jonasblixt/bebop/README.md

# bebop
Power-over-ethernet BLE bridge. This is a work in progress. 

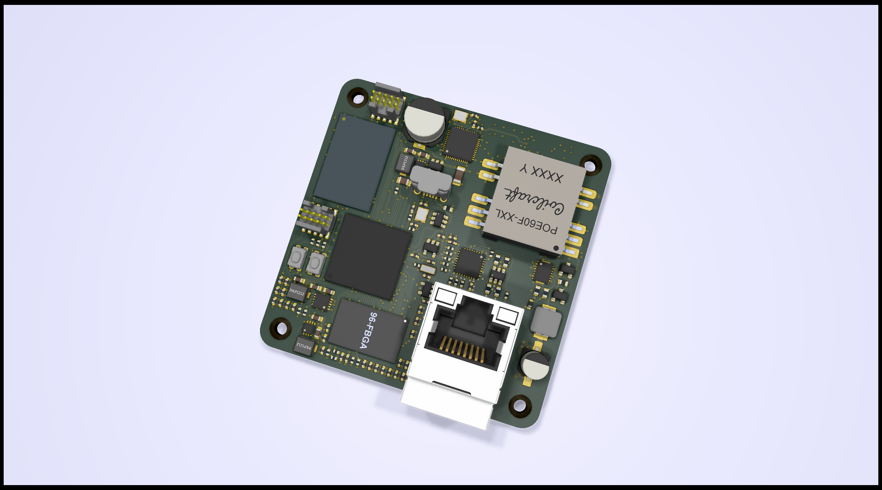
[picture p1: hw/release/R1/Bebop R1 3D front.png]
Bebop PCB
