jonasblixt/bebop/hw/release/R1/Bebop R1 3D back.png

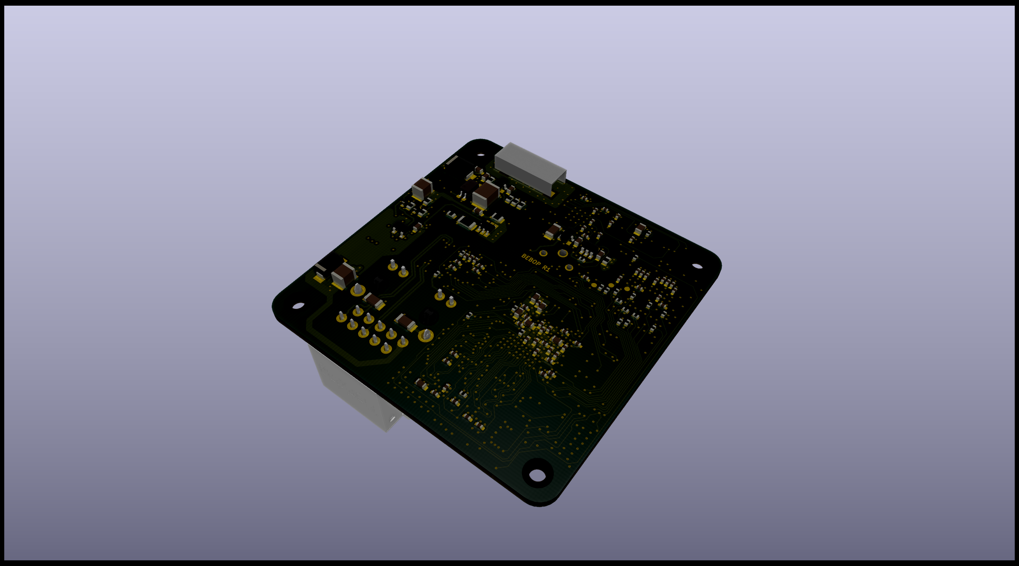
hw/release/R1/Bebop R1 3D back.png
