jonasblixt/bebop/hw/release/R1/Bebop R1 Schematics.pdf

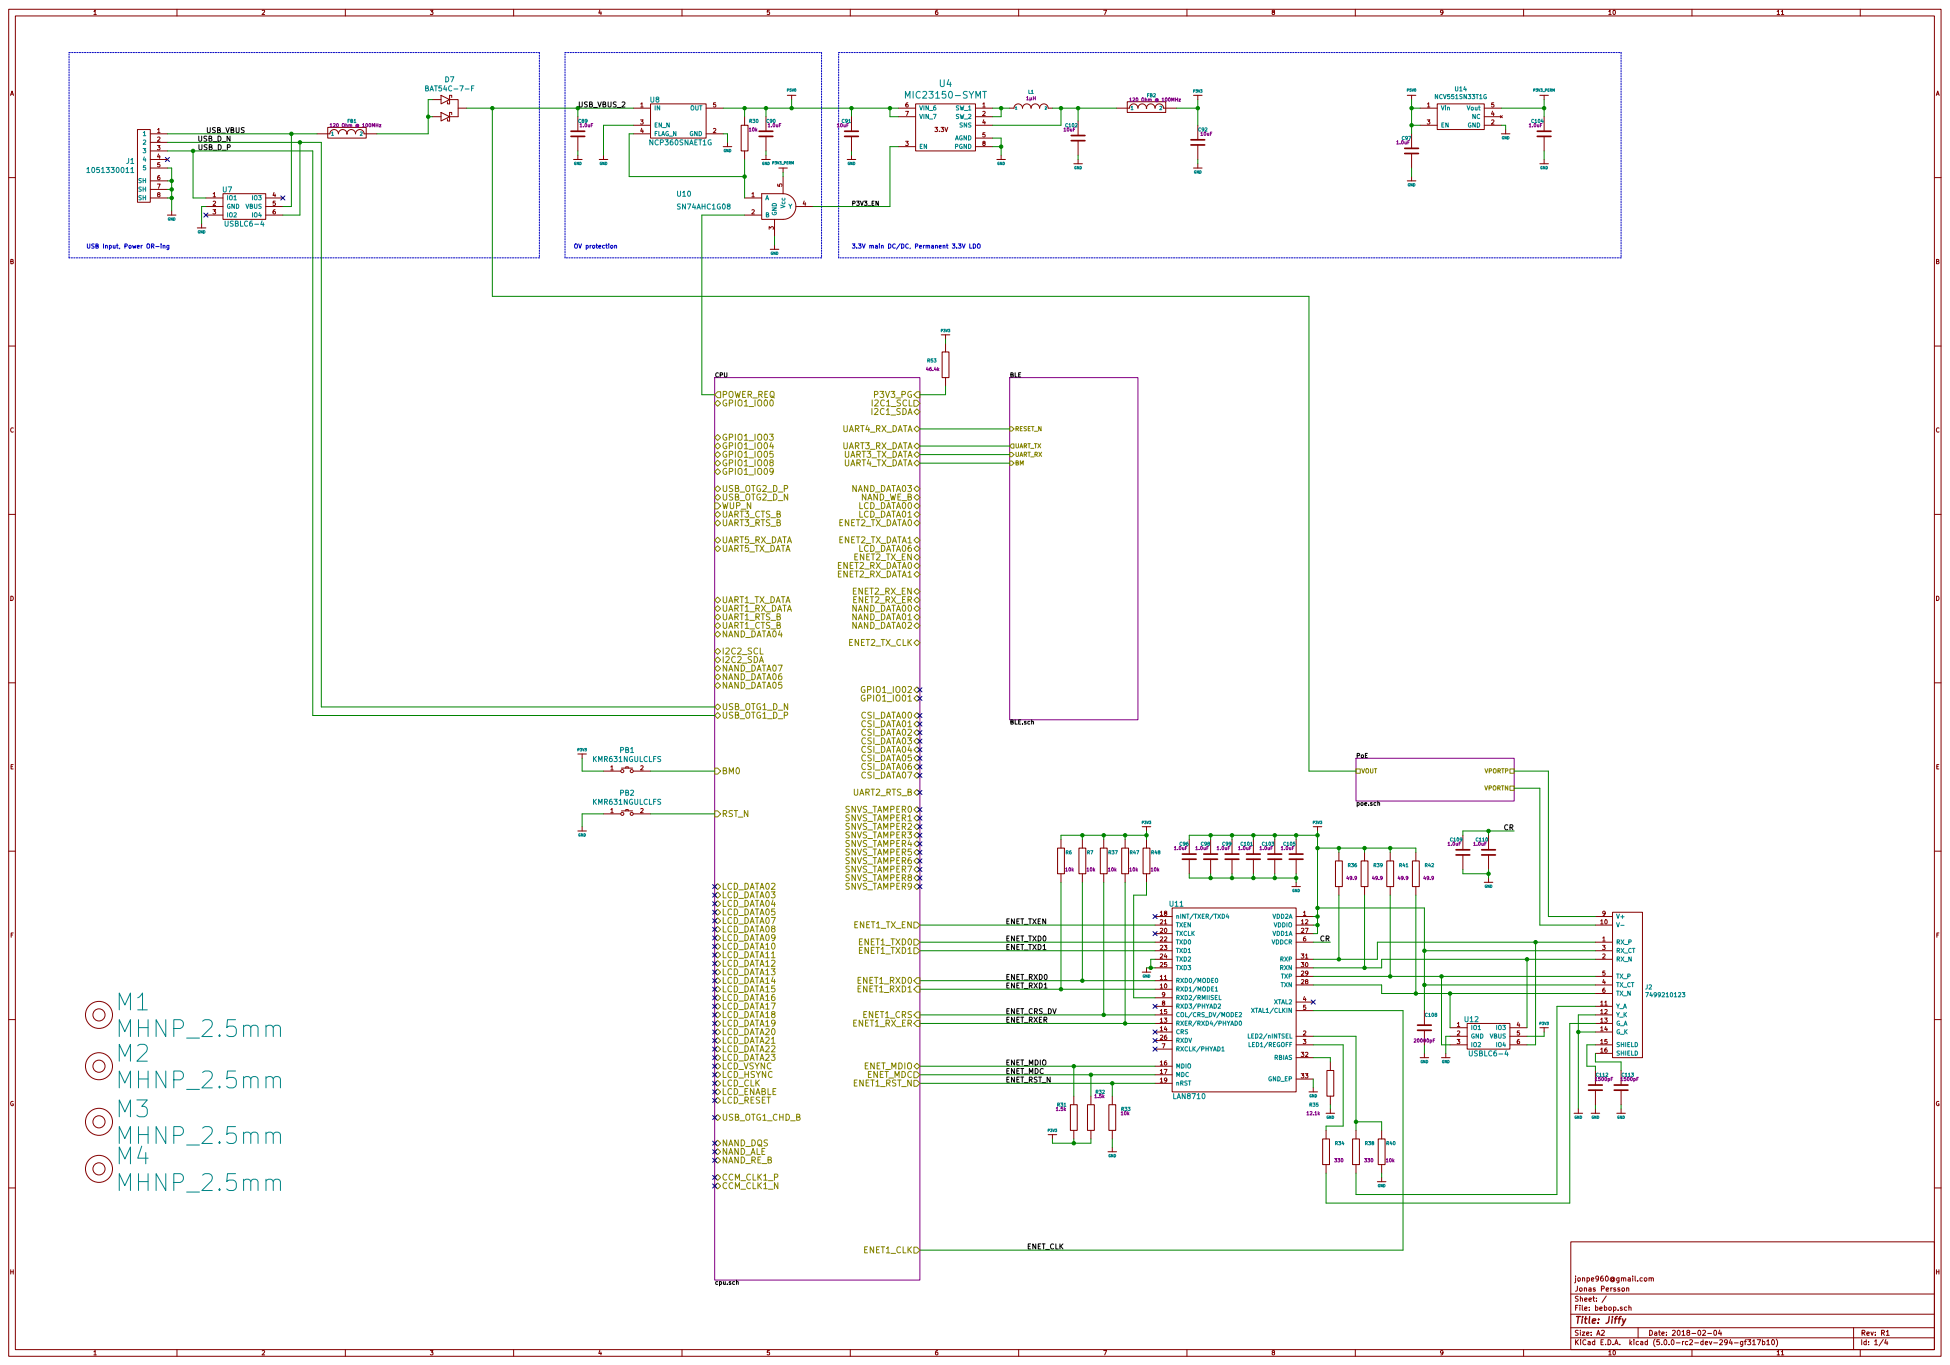
[picture p3: page 1]

ENET_MDC
ENET_RST_N | nRST 19

jonpe960@gmail.com
File: bebop.sch Sheet: / Jonas Persson

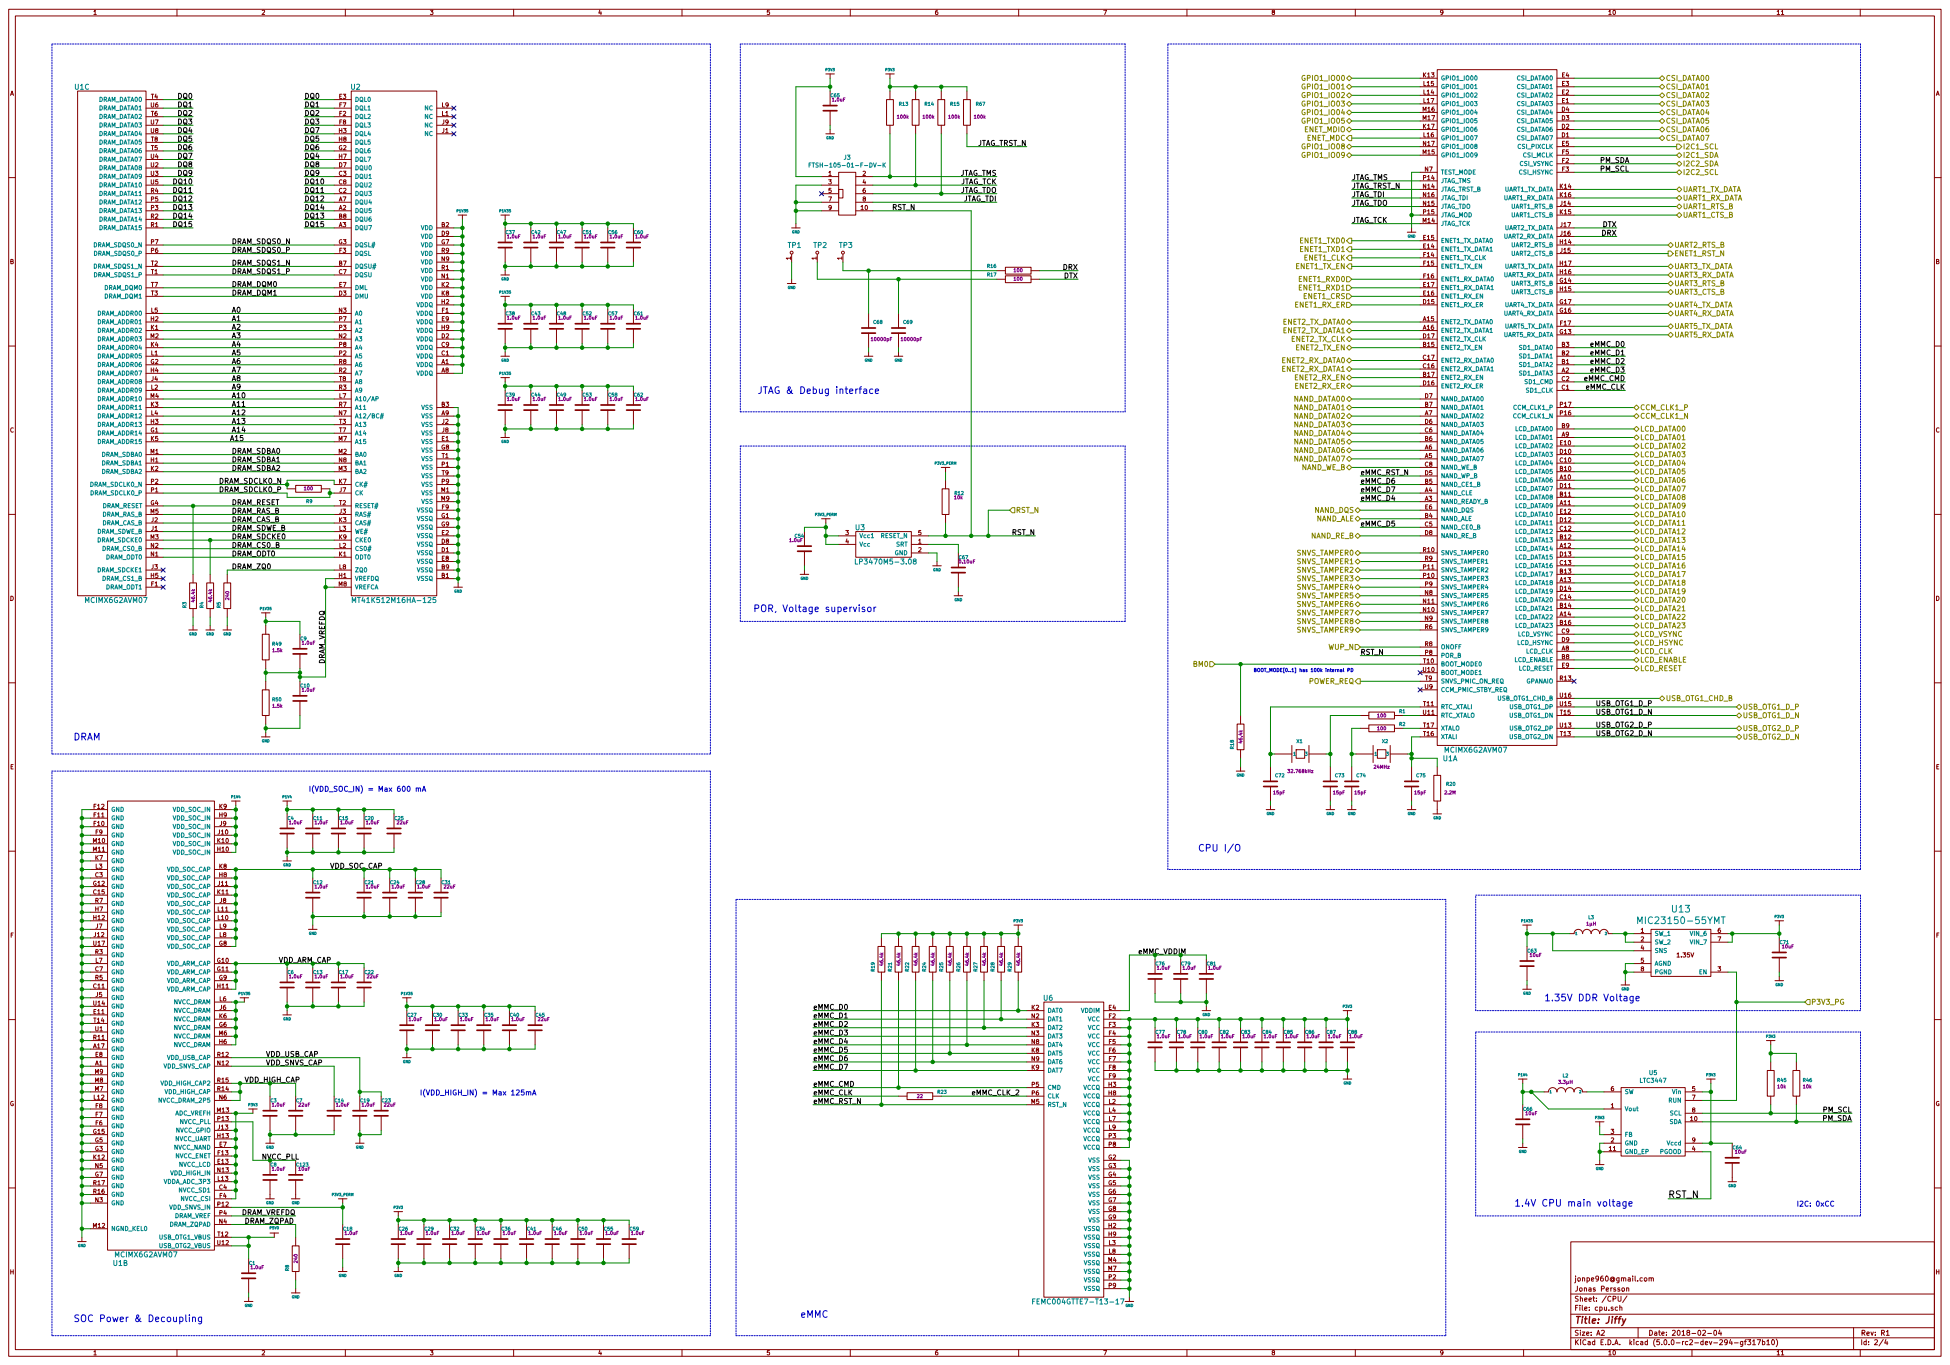
[picture p4: page 2]

GND 1.4V CPU main voltage

jonpe960@gmail.com
File: cpu.sch Sheet: /CPU/ Jonas Persson

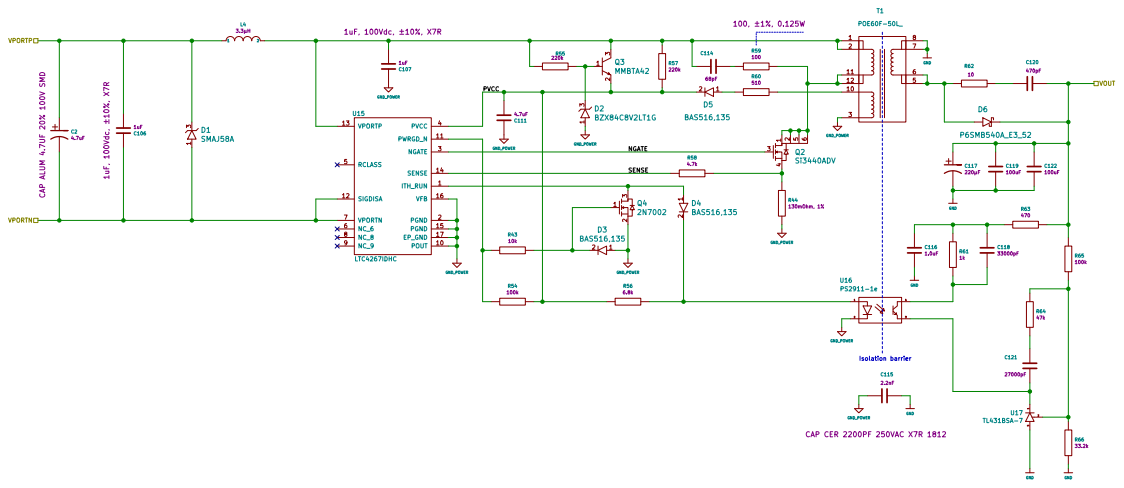
[picture p5: page 3]

File: poe.sch Sheet: /PoE/

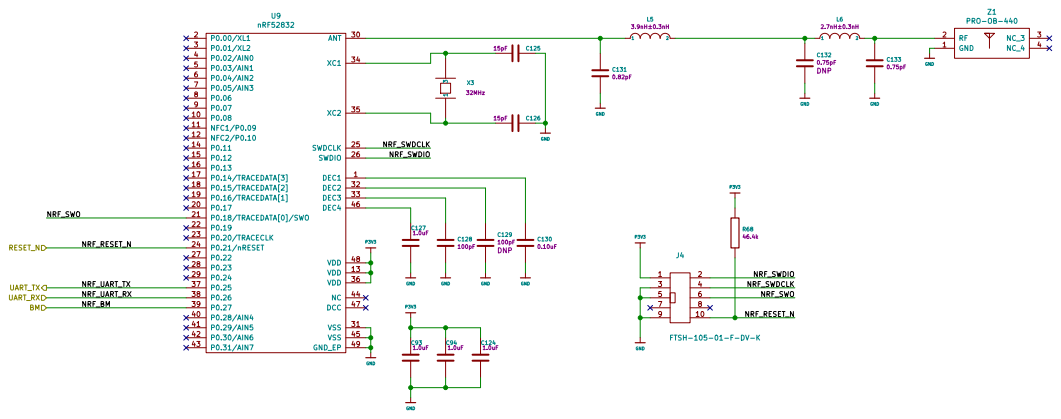
[picture p6: page 4]

Id: 4/4 Title: File: BLE.sch Sheet: /BLE/
