jonasblixt/bebop/hw/release/R1/Bebop R1 Assy.pdf

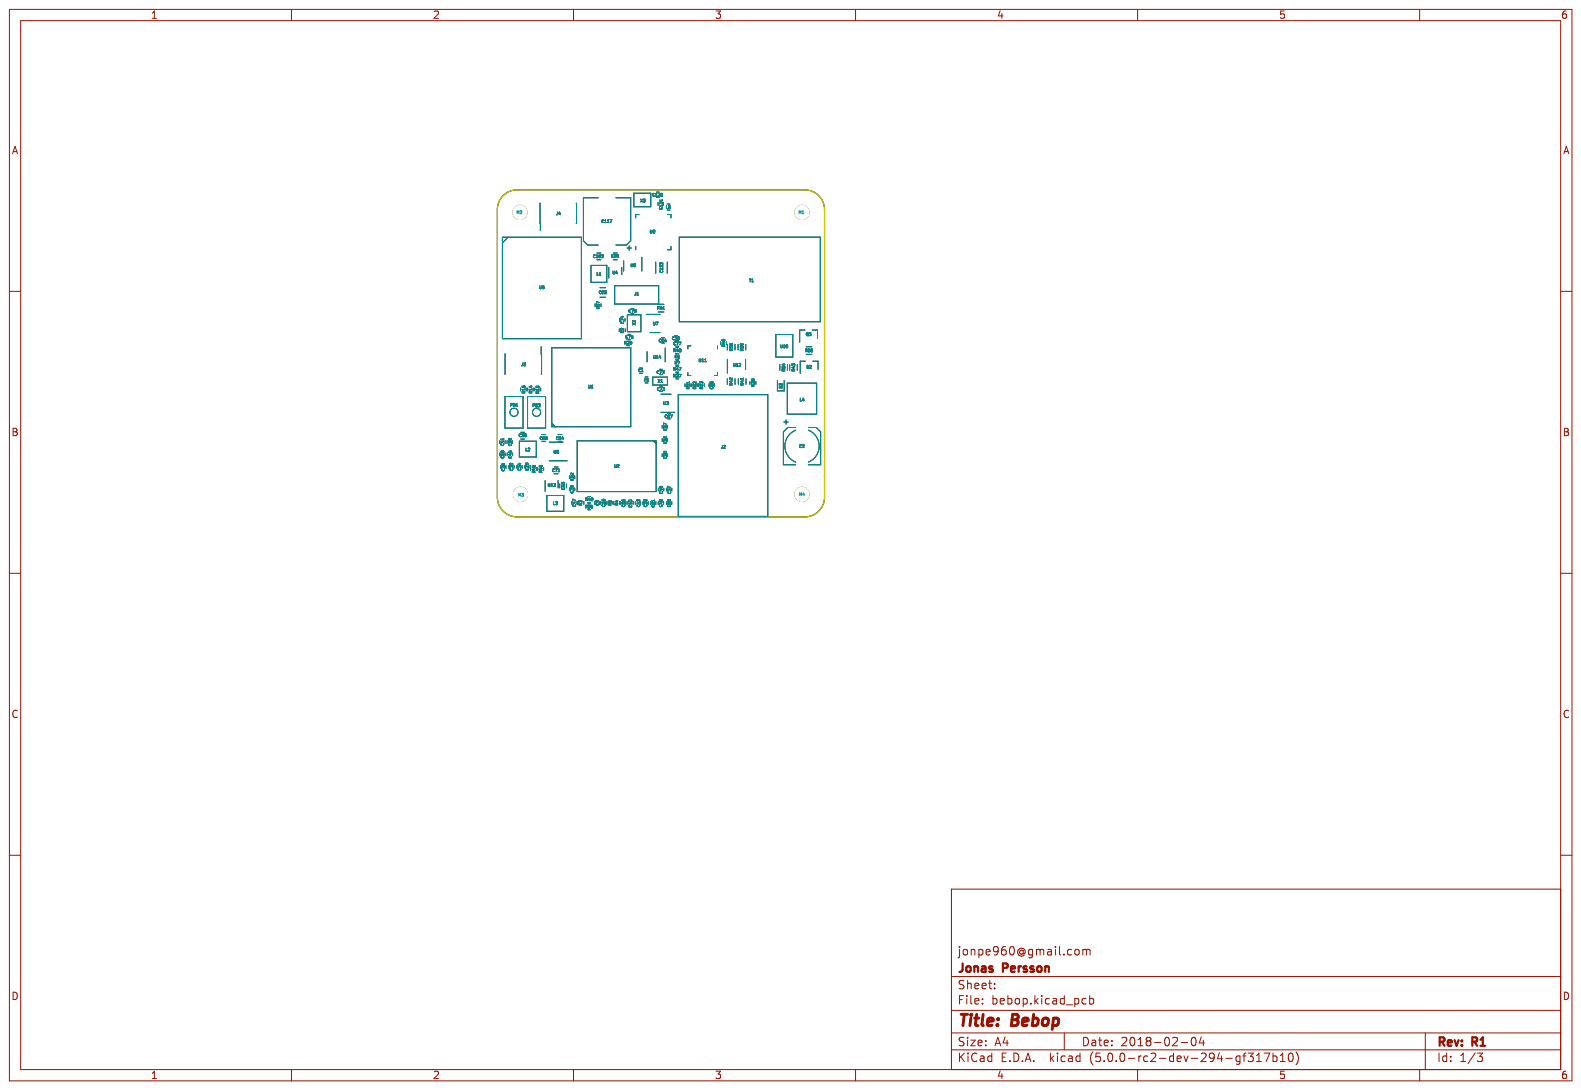
[picture p7: page 1]

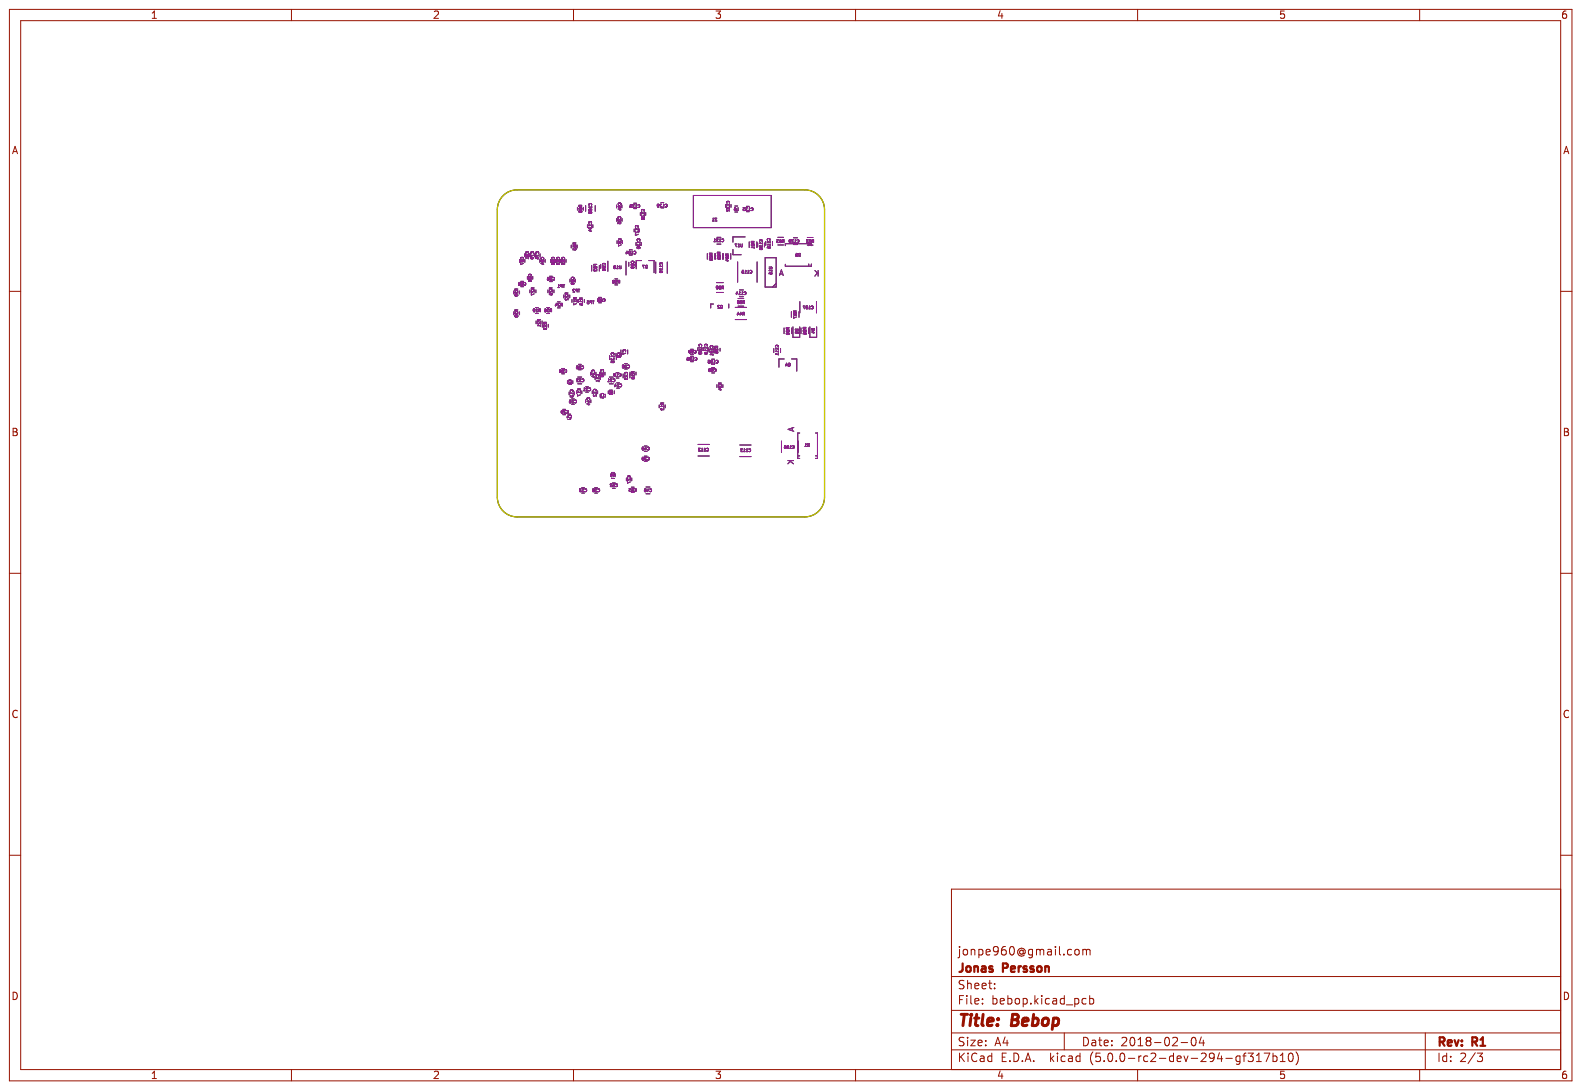
[picture p8: page 2]

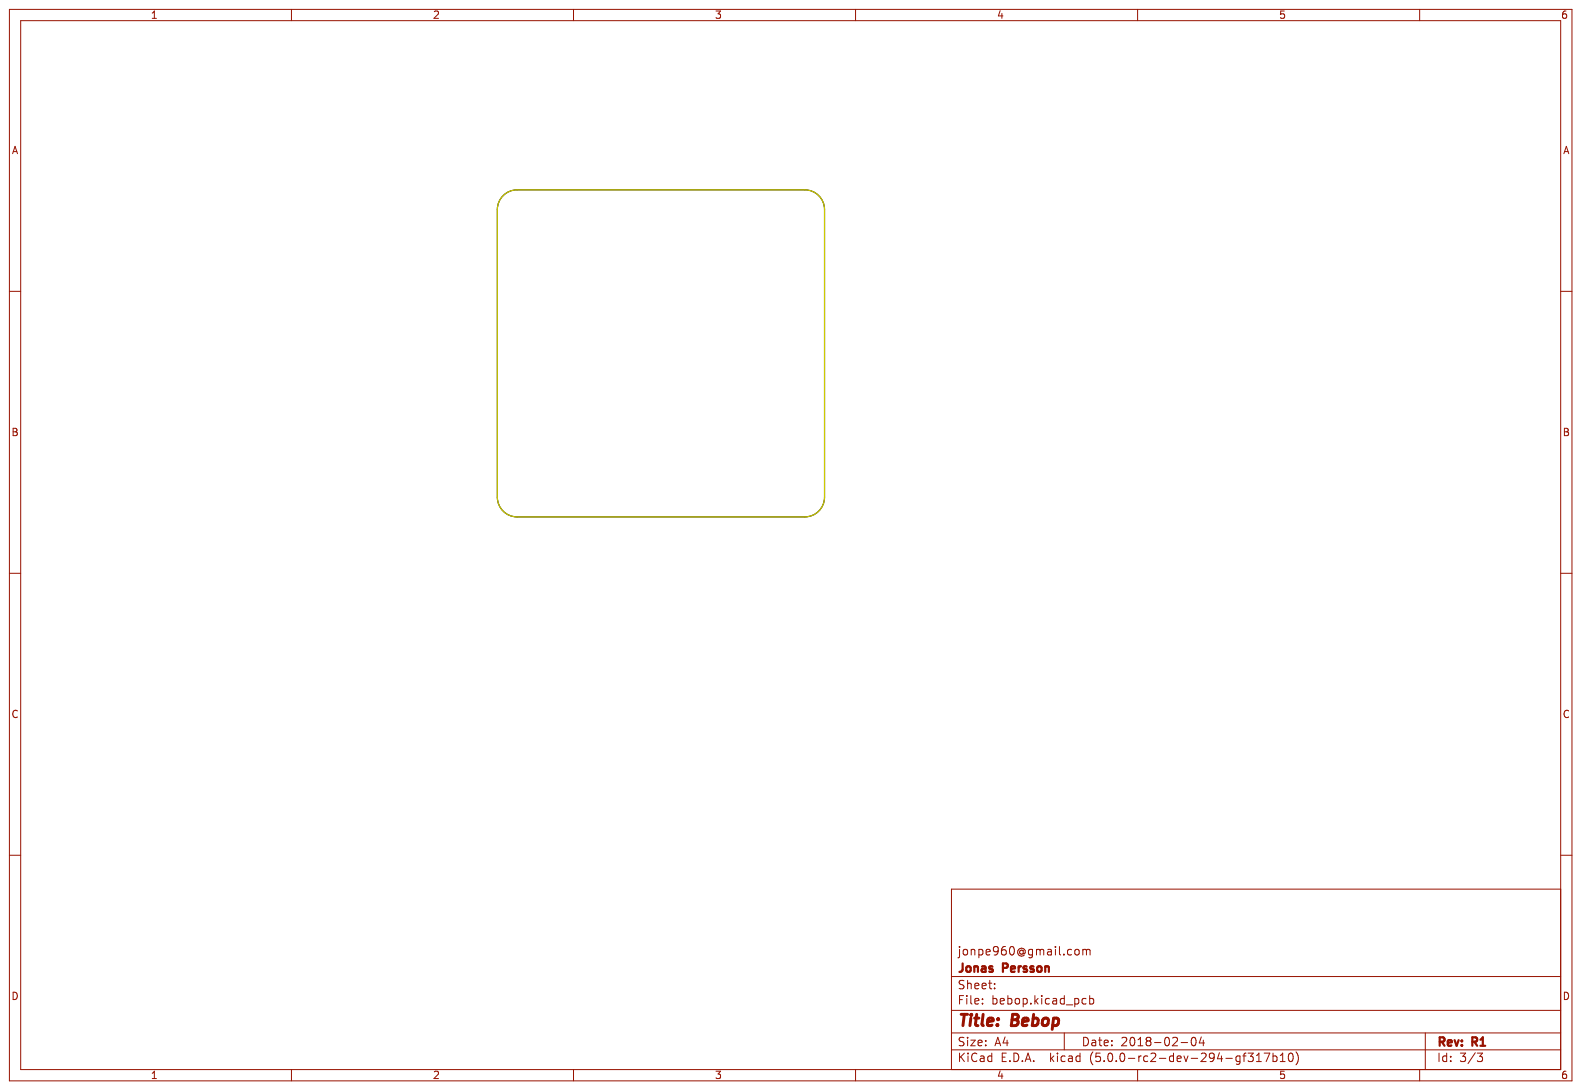
[picture p9: page 3]
