jonasblixt/bebop/hw/design/bebop.kicad_pcb

## KiCad design hw/design/bebop.kicad_pcb (2018-03-30)

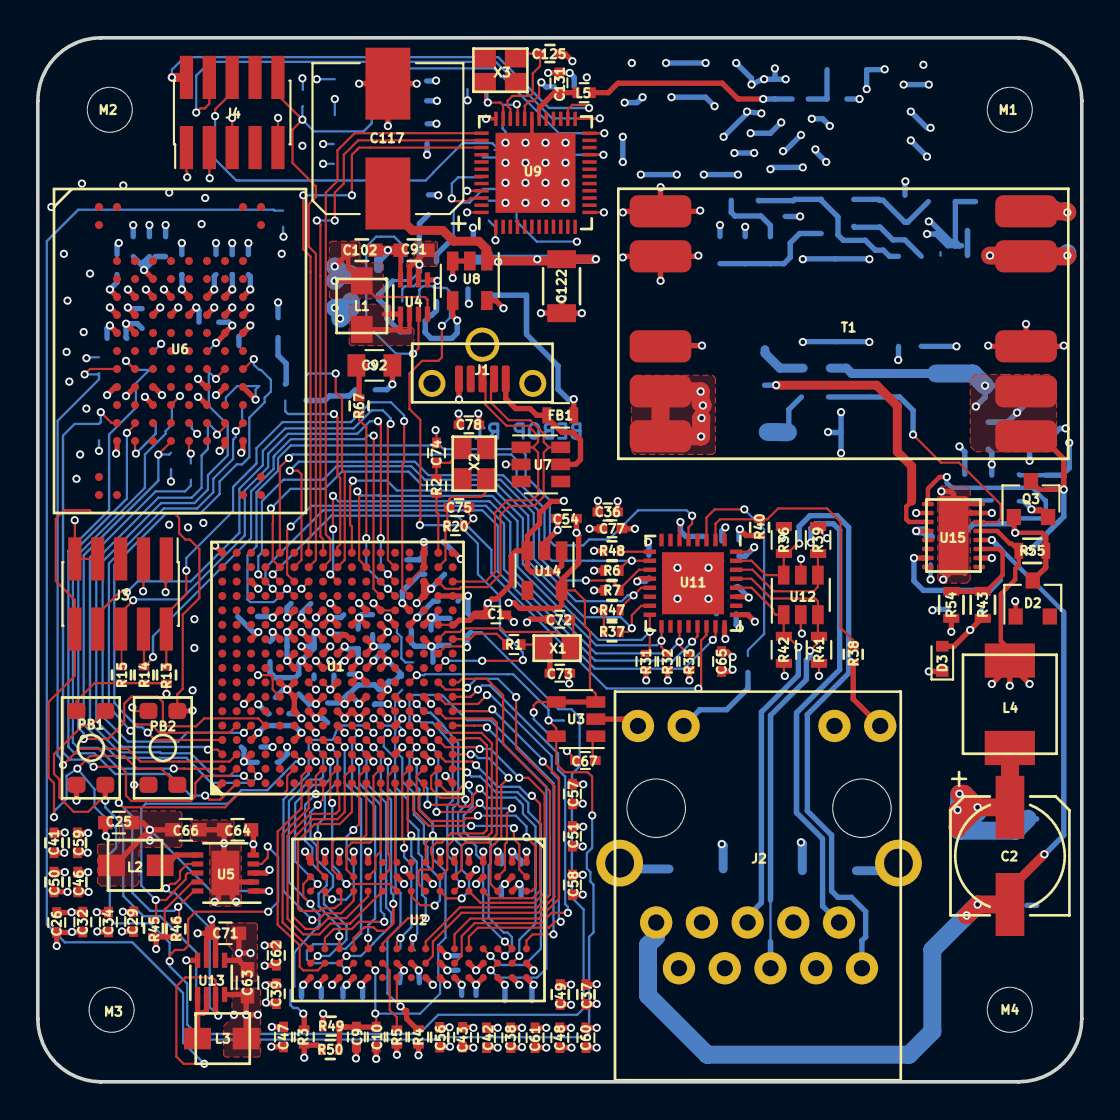
[picture p10: board bebop.kicad_pcb from above]

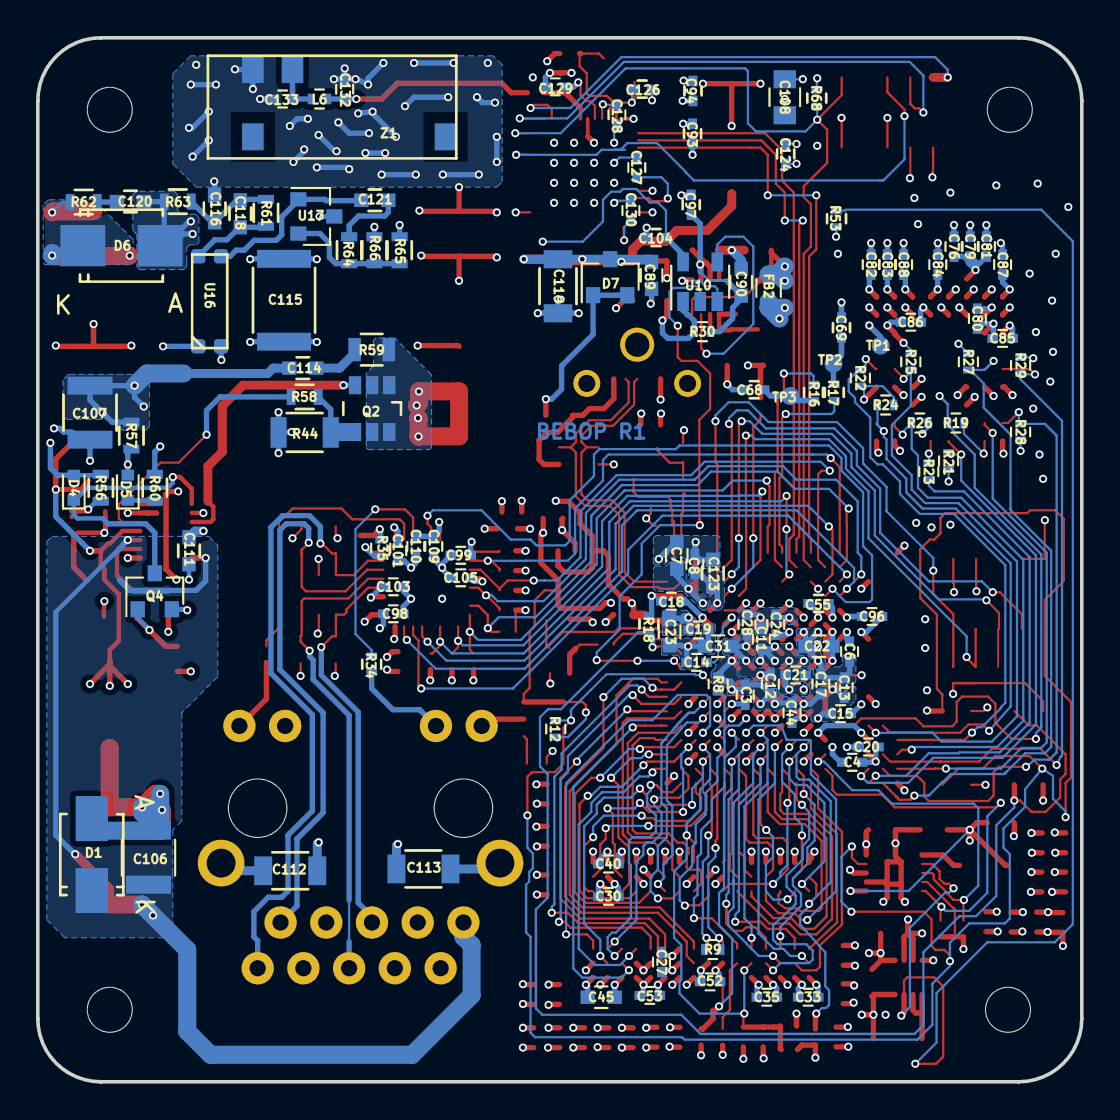
[picture p11: board bebop.kicad_pcb from below]

Board: 4 copper layers, 58.0 x 58.0 mm, 245 parts (128 on the bottom side), 175 nets.

Parts:
C1, C3, C4, C6, C8, C9, C10, C11, C12, C13, C14, C15, C17, C18, C19, C20, C21, C24, C26, C27, C28, C29, C30, C32, C33, C34, C35, C36, C37, C38, C39, C40, C41, C42, C43, C44, C46, C47, C48, C49, C50, C51, C52, C53, C54, C55, C56, C57, C58, C59, C60, C61, C62, C65, C76, C77, C78, C79, C80, C81, C82, C83, C84, C85, C86, C87, C88, C93, C94, C96, C97, C98, C99, C101, C103, C104, C105, C109, C110, C124, C127: C0402_1u_10Vdc_X5R; C_0402
C2: PCAP_220u_15; c_elec_6.3x7.7
C7, C22, C23, C25, C31, C45: C0603_22u_10Vdc_X5R; C_0603
C63, C64, C66, C71, C91, C102, C123: C0603_10u_10Vdc_X7R; C_0603
C67: C0402_100n_100Vdc_X5R; C_0402
C68, C69: C0402_10n_50Vdc_X7R; C_0402
C72, C73, C74, C75, C125, C126: C0402_15p_100Vdc_C0G; C_0402
C89, C90: C0603_1u_25Vdc_X7R; C_0603
C92: C0805_10u_25Vdc_X7R; C_0805
C106, C107: C1210_1u_100Vdc_X7R; C_1210
C108: C0805_20n_50Vdc_X7R; C_0805
C111: C0603_4u7_10Vdc_X7R; C_0603
C112, C113: C1206_1n5_1000Vdc_X7R; C_1206
C114: C0603_68p_200Vdc_X7R; C_0603
C115: C1812_2n2_250Vac_X7R; C_1812
C116: C0603_1u_10Vdc_X7R; C_0603
C117: PCAP_220u_15; CP_Elec_8x5.4
C118: C0603_33n_16Vdc_X7R; C_0603
C119, C122: C1206_100u_6.3Vdc_X5R; C_1206
C120: C0603_470p_100Vdc_X7R; C_0603
C121: C0603_27n_16Vdc_X7R; C_0603
C128, C129: C0402_100p_25Vdc_C0G; C_0402
C130: C0402_100n_10Vdc_X7R; C_0402
C131: C0402_0p8_25Vdc_C0G_5; C_0402
C132, C133: C0402_0p8_50Vdc_C0G_3; C_0402
D1: SMAJ58A; SMA_Standard
D2: BZX84C8V2LT1G; SOT-23
D3, D4, D5: BAS516,135; D_SOD-523
D6: P6SMB540A_E3_52; SMB_Standard
D7: BAT54C-7-F; SOT-23
FB1, FB2: BL0603_BLM18KG121TN1D; R_0603
J1: 1051330011
J2: 7499210123
J3, J4: FTSH-105-01-F-DV-K
L1, L3: IHLP1212_1u_1; IHLP1212
L2: IHLP1212_3u3_a5; IHLP1212
L4: IHLP2020_3u3_13; IHLP2020
L5: LQG15HN_3n9; L_0402
L6: LQG15HN_2n7; L_0402
M1, M2, M3, M4: MHNP_2.5mm; MH_2.5mm
PB1, PB2: KMR631NGULCLFS; kmr6
Q2: Si3440ADV; TSOT-6-MK06A
Q3: MMBTA42; SOT-23
Q4: 2N7002; SOT-23
R1, R2, R9, R16, R17: R0402_100R; R_0402
R3, R4, R18, R19, R21, R22, R24, R25, R26, R27, R28, R29, R53, R68: R0402_46k40; R_0402
R5, R8: R0402_240R; R_0402
R6, R7, R12, R30, R33, R37, R40, R45, R46, R47, R48: R0402_10k; R_0402
R13, R14, R15, R67: R0402_100k; R_0402
R20: R0402_2M20; R_0402
R23: R0402_22R; R_0402
R31, R32, R49, R50: R0402_1k50; R_0402
R34, R38: R0402_330R; R_0402
R35: R0402_12k10; R_0402
R36, R39, R41, R42: R0603_49R90; R_0603
R43: R0603_10k; R_0603
R44: R1206_0R130; R_1206
R54, R65: R0603_100k; R_0603
R55, R57: R0603_220k; R_0603
R56: R0603_6k80; R_0603
R58: R0603_4k70; R_0603
R59: R0805_100R_126mW; R_0805
R60: R0603_510R; R_0603
R61: R0603_1k; R_0603
R62: R0603_10R; R_0603
R63: R0603_470R; R_0603
R64: R0603_47k; R_0603
R66: R0603_33k20; R_0603
T1: POE60F-50L_; POE60F
TP1, TP2, TP3: TP; TP_1mm
U1: MCIMX6G2AVM07; LFBGA289
U2: MT41K512M16HA-125; BGA-96_pitch0.8mm_dia0.4mm
U3: LP3470M5-3.08; SOT-23-5
U4: MIC23150-SYMT; DFN-8_2x2mm_Pitch0.5mm
U5: LTC3447; DFN-10-1EP_3x3mm_Pitch0.5mm
U6: FEMC004GTTE7-T13-17; 100LBGA_DQ
U7, U12: USBLC6-4; SOT-23-6
U8: NCP360SNAET1G; SOT-23-5
U9: nRF52832; UQFN-48-1EP_6x6mm_Pitch0.4mm
U10: SN74AHC1G08; SOT-23-5
U11: LAN8710; QFN-32-1EP_5x5mm_Pitch0.5mm
U13: MIC23150-55YMT; DFN-8_2x2mm_Pitch0.5mm
U14: NCV551SN33T1G; SOT-23-5
U15: LTC4267IDHC; DHC16
U16: PS2911-1e; PS2911
U17: TL431BSA-7; SOT-23
X1: NX2012SA-32.768K-STD-MUB-1; NX2012
X2: NX2520SA-24.000000MHZ; NX2520
X3: NX2520SA-32.000000MHZ; NX2520
Z1: PRO-OB-440

Connections:
/BLE/BM: U1.G17, U9.39
/BLE/NRF_SWDCLK: J4.4, U9.25
/BLE/NRF_SWDIO: J4.2, U9.26
/BLE/NRF_SWO: J4.6, U9.21
/BLE/RESET_N: J4.10, R68.2, U1.G16, U9.24
/CPU/A0: U1.L5, U2.N3
/CPU/A1: U1.H2, U2.P7
/CPU/A2: U1.K1, U2.P3
/CPU/A3: U1.M2, U2.N2
/CPU/A4: U1.K4, U2.P8
/CPU/A5: U1.L1, U2.P2
/CPU/A6: U1.G2, U2.R8
/CPU/A7: U1.H4, U2.R2
/CPU/A8: U1.J4, U2.T8
/CPU/A9: U1.L2, U2.R3
/CPU/A10: U1.M4, U2.L7
/CPU/A11: U1.K3, U2.R7
/CPU/A12: U1.L4, U2.N7
/CPU/A13: U1.H3, U2.T3
/CPU/A14: U1.G1, U2.T7
/CPU/A15: U1.K5, U2.M7
/CPU/BM0: PB1.2, R18.1, U1.T10
/CPU/DQ0: U1.T4, U2.E3
/CPU/DQ1: U1.U6, U2.F7
/CPU/DQ2: U1.T6, U2.F2
/CPU/DQ3: U1.U7, U2.F8
/CPU/DQ4: U1.U8, U2.H7
/CPU/DQ5: U1.T8, U2.H8
/CPU/DQ6: U1.T5, U2.G2
/CPU/DQ7: U1.U4, U2.H3
/CPU/DQ8: U1.U2, U2.D7
/CPU/DQ9: U1.U3, U2.C3
/CPU/DQ10: U1.U5, U2.C8
/CPU/DQ11: U1.R4, U2.C2
/CPU/DQ12: U1.P5, U2.A7
/CPU/DQ13: U1.P3, U2.B8
/CPU/DQ14: U1.R2, U2.A2
/CPU/DQ15: U1.R1, U2.A3
/CPU/DRAM_CAS_B: U1.J2, U2.K3
/CPU/DRAM_CS0_B: U1.N2, U2.L2
/CPU/DRAM_DQM0: U1.T7, U2.E7
/CPU/DRAM_DQM1: U1.T3, U2.D3
/CPU/DRAM_ODT0: U1.N1, U2.K1
/CPU/DRAM_RAS_B: U1.M5, U2.J3
/CPU/DRAM_RESET: R3.1, U1.G4, U2.T2
/CPU/DRAM_SDBA0: U1.M1, U2.M2
/CPU/DRAM_SDBA1: U1.H1, U2.N8
/CPU/DRAM_SDBA2: U1.K2, U2.M3
/CPU/DRAM_SDCKE0: R4.1, U1.M3, U2.K9
/CPU/DRAM_SDCLK0_N: R9.1, U1.P2, U2.K7
/CPU/DRAM_SDCLK0_P: R9.2, U1.P1, U2.J7
/CPU/DRAM_SDQS0_N: U1.P7, U2.G3
/CPU/DRAM_SDQS0_P: U1.P6, U2.F3
/CPU/DRAM_SDQS1_N: U1.T2, U2.B7
/CPU/DRAM_SDQS1_P: U1.T1, U2.C7
/CPU/DRAM_SDWE_B: U1.J1, U2.L3
/CPU/DRAM_VREFDQ: C9.2, C10.1, R49.2, R50.1, U1.P4, U2.H1, U2.M8
/CPU/DRAM_ZQ0: R5.1, U2.L8
/CPU/DRAM_ZQPAD: R8.1, U1.N4
/CPU/DRX: R16.2, U1.J16
/CPU/DTX: R17.2, U1.J17
/CPU/I2C2_SCL: R45.2, U1.F3, U5.8
/CPU/I2C2_SDA: R46.2, U1.F2, U5.10
/CPU/JTAG_TCK: J3.4, R14.2, U1.M14
/CPU/JTAG_TDI: J3.8, U1.N16
/CPU/JTAG_TDO: J3.6, R15.2, U1.N15
/CPU/JTAG_TMS: J3.2, R13.2, U1.P14
/CPU/JTAG_TRST_N: R67.2, U1.N14
/CPU/NVCC_PLL: C8.1, C123.1, U1.P13
/CPU/P3V3_PG: R53.2, U5.7, U13.3
/CPU/POWER_REQ: U1.T9, U10.2
/CPU/RST_N: J3.10, PB2.2, R12.2, U1.P8, U3.5, U5.4
/CPU/UART3_RX_DATA: U1.H16, U9.37
/CPU/UART3_TX_DATA: U1.H17, U9.38
/CPU/VDD_ARM_CAP: C6.1, C13.1, C17.1, C22.1, U1.G9, U1.G10, U1.G11, U1.H11
/CPU/VDD_HIGH_CAP: C3.1, C7.1, U1.N6, U1.R14, U1.R15
/CPU/VDD_SNVS_CAP: C14.1, U1.N12
/CPU/VDD_SOC_CAP: C12.1, C21.1, C24.1, C28.1, C31.1, U1.G8, U1.H8, U1.J8, U1.J11, U1.K8, U1.K11, U1.L8, U1.L9, U1.L10, U1.L11
/CPU/VDD_USB_CAP: C19.1, C23.1, U1.R12
/CPU/eMMC_CLK: R23.2, U1.C1
/CPU/eMMC_CLK_2: R23.1, U6.P6
/CPU/eMMC_CMD: R21.2, U1.C2, U6.P5
/CPU/eMMC_D0: R29.2, U1.B3, U6.K2
/CPU/eMMC_D1: R28.2, U1.B2, U6.N2
/CPU/eMMC_D2: R27.2, U1.B1, U6.K3
/CPU/eMMC_D3: U1.A2, U6.N3
/CPU/eMMC_D4: R26.2, U1.A3, U6.N8
/CPU/eMMC_D5: R25.2, U1.C5, U6.K8
/CPU/eMMC_D6: R24.2, U1.B5, U6.N9
/CPU/eMMC_D7: R22.2, U1.A4, U6.K9
/CPU/eMMC_RST_N: R19.2, U1.D5, U6.M5
/CPU/eMMC_VDDIM: C76.1, C79.1, C81.1, U6.E4
/CR: C109.1, C110.1, U11.6
/ENET_CLK: U1.F14, U11.5
/ENET_CRS_DV: R37.2, U1.E16, U11.15
/ENET_MDC: R32.1, U1.L16, U11.17
/ENET_MDIO: R31.1, U1.K17, U11.16
/ENET_RST_N: R33.1, U1.J15, U11.19
/ENET_RXD0: R7.2, U1.F16, U11.11
/ENET_RXD1: R6.2, U1.E17, U11.10
/ENET_RXER: R47.2, U1.D15, U11.13
/ENET_TXD0: U1.E15, U11.22
/ENET_TXD1: U1.E14, U11.23
/ENET_TXEN: U1.F15, U11.21
/P3V3_EN: U4.3, U10.4
/PoE/NGATE: Q2.3, U15.3
/PoE/PVCC: C111.2, D5.2, Q3.2, R54.1, R56.2, R57.2, U15.4
/PoE/SENSE: R58.2, U15.14
/PoE/VPORTN: C2.2, C106.1, D1.1, J2.10, U15.7, U15.12
/PoE/VPORTP: C2.1, C106.2, D1.3, J2.9, L4.1
/USB_D_N: J1.2, U1.T15, U7.6
/USB_D_P: J1.3, U1.U15, U7.1
/USB_VBUS: FB1.1, J1.1, U7.5
/USB_VBUS_2: C89.1, C117.1, C119.1, C120.1, C122.1, D6.2, D7.3, R63.1, R65.1, U8.1
GND: C1.2, C3.2, C4.2, C6.2, C7.2, C8.2, C10.2, C11.2, C12.2, C13.2, C14.2, C15.2, C17.2, C18.2, C19.2, C20.2, C21.2, C22.2, C23.2, C24.2, C25.2, C26.2, C27.2, C28.2, C29.2, C30.2, C31.2, C32.2, C33.2, C34.2, C35.2, C36.2, C37.2, C38.2, C39.2, C40.2, C41.2, C42.2, C43.2, C44.2, C45.2, C46.2, C47.2, C48.2, C49.2, C50.2, C51.2, C52.2, C53.2, C54.2, C55.2, C56.2, C57.2, C58.2, C59.2, C60.2, C61.2, C62.2, C63.2, C64.2, C65.2, C66.2, C67.2, C68.2, C69.2, C71.2, C72.2, C73.2, C74.2, C75.2, C76.2, C77.2, C78.2, C79.2, C80.2, C81.2, C82.2, C83.2, C84.2, C85.2, C86.2, C87.2, C88.2, C89.2, C90.2, C91.2, C92.2, C93.2, C94.2, C96.2, C97.2, C98.2, C99.2, C101.2, C102.2, C103.2, C104.2, C105.2, C108.2, C109.2, C110.2, C112.2, C113.2, C115.1, C116.2, C117.2, C119.2, C122.2, C123.2, C124.2, C125.1, C126.1, C127.2, C128.2, C129.2, C130.2, C131.2, C132.2, C133.2, J1.5, J1.6, J1.7, J1.8, J2.12, J2.14, J3.3, J3.7, J3.9, J4.3, J4.5, J4.9, PB2.1, R3.2, R4.2, R5.2, R8.2, R18.2, R20.2, R33.2, R35.2, R40.2, R50.2, R66.2, T1.7, T1.8, TP1.1, U1.A1, U1.A17, U1.C3, U1.C7, U1.C11, U1.C15, U1.E8, U1.E11, U1.F6, U1.F7, U1.F8, U1.F9, U1.F10, U1.F11, U1.F12, U1.G3, U1.G5, U1.G7, U1.G12, U1.G15, U1.H7, U1.H12, U1.J5, U1.J7, U1.J12, U1.K7, U1.K12, U1.L3, U1.L7, U1.L12, U1.M7, U1.M8, U1.M9, U1.M10, U1.M11, U1.M12, U1.N3, U1.N5, U1.N7, U1.P15, U1.R3, U1.R5, U1.R7, U1.R11, U1.R16, U1.R17, U1.T14, U1.U1, U1.U14, U1.U17, U2.A9, U2.B1, U2.B3, U2.B9, U2.D1, U2.D8, U2.E1, U2.E2, U2.E8, U2.F9, U2.G1, U2.G8, U2.G9, U2.J2, U2.J8, U2.M1, U2.M9, U2.P1, U2.P9, U2.T1, U2.T9, U3.2, U4.5, U4.8, U5.2, U5.11, U6.G2, U6.G3, U6.G4, U6.G5, U6.G6, U6.G7, U6.G8, U6.G9, U6.H2, U6.H9, U6.L3, U6.L8, U6.M4, U6.M7, U6.P2, U6.P9, U7.2, U8.2, U8.3, U9.31, U9.45, U9.49, U10.3, U11.24, U11.25, U11.33, U12.2, U13.5, U13.8, U14.2, U17.3, Z1.1
GND_POWER: C107.1, C111.1, C115.2, D2.1, D3.1, Q4.2, R44.2, T1.3, U15.2, U15.10, U15.15, U15.16, U15.17, U16.2
unnamed: C67.1, U3.1
unnamed: C68.1, R16.1, TP3.1
unnamed: C69.1, R17.1, TP2.1
unnamed: C72.1, U1.T11, X1.1
unnamed: C73.1, R1.2, X1.3
unnamed: C74.1, R2.2, X2.1
unnamed: C75.1, R20.1, U1.T16, X2.3
unnamed: C102.1, FB2.1, L1.2, U4.4
unnamed: C107.2, C114.1, L4.2, Q3.3, R55.2, R57.1, T1.1, T1.2, U15.13
unnamed: C112.1, J2.15
unnamed: C113.1, J2.16
unnamed: C114.2, R59.2
unnamed: C116.1, C118.1, R61.1, R63.2
unnamed: C118.2, R61.2, U16.4
unnamed: C120.2, R62.2
unnamed: C121.1, R64.2
unnamed: C121.2, U16.3, U17.1
unnamed: C125.2, U9.34, X3.3
unnamed: C126.2, U9.35, X3.1
unnamed: C127.1, U9.46
unnamed: C128.1, U9.33
unnamed: C129.1, U9.32
unnamed: C130.1, U9.1
unnamed: C131.1, L5.1, U9.30
unnamed: C132.1, L5.2, L6.1
unnamed: C133.1, L6.2, Z1.2
unnamed: D2.3, Q3.1, R55.1
unnamed: D3.2, Q4.1, R43.1
unnamed: D4.1, Q4.3, U15.1
unnamed: D4.2, R56.1, U16.1
unnamed: D5.1, R60.2
unnamed: D6.1, R62.1, T1.5, T1.6
unnamed: D7.1, D7.2, FB1.2
unnamed: J2.1, R36.2, U11.31, U12.6
unnamed: J2.2, R39.2, U11.30, U12.4
unnamed: J2.5, R41.2, U11.29, U12.3
unnamed: J2.6, R42.2, U11.28, U12.1
unnamed: J2.11, R38.2
unnamed: J2.13, R34.2
unnamed: L1.1, U4.1, U4.2
unnamed: L2.2, U5.6
unnamed: L3.2, U13.1, U13.2
unnamed: Q2.1, Q2.2, Q2.5, Q2.6, R59.1, T1.11, T1.12
unnamed: Q2.4, R44.1, R58.1
unnamed: R1.1, U1.U11
unnamed: R2.1, U1.T17
unnamed: R30.2, U8.4, U10.1
unnamed: R34.1, U11.3
unnamed: R35.1, U11.32
unnamed: R38.1, R40.1, U11.2
unnamed: R43.2, R54.2, U15.11
unnamed: R48.2, U11.9
unnamed: R60.1, T1.10
unnamed: R64.1, R65.2, R66.1, U17.2
P1V4: C4.1, C11.1, C15.1, C20.1, C25.1, C66.1, L2.1, U1.H9, U1.H10, U1.J9, U1.J10, U1.K9, U1.K10, U5.1
P1V35: C9.1, C27.1, C30.1, C33.1, C35.1, C37.1, C38.1, C39.1, C40.1, C42.1, C43.1, C44.1, C45.1, C47.1, C48.1, C49.1, C51.1, C52.1, C53.1, C56.1, C57.1, C58.1, C60.1, C61.1, C62.1, C63.1, L3.1, R49.1, U1.G6, U1.H6, U1.J6, U1.K6, U1.L6, U1.M6, U2.A1, U2.A8, U2.B2, U2.C1, U2.C9, U2.D2, U2.D9, U2.E9, U2.F1, U2.G7, U2.H2, U2.H9, U2.K2, U2.K8, U2.N1, U2.N9, U2.R1, U2.R9, U13.4
P3V3: C26.1, C29.1, C32.1, C34.1, C36.1, C41.1, C46.1, C50.1, C55.1, C59.1, C64.1, C65.1, C71.1, C77.1, C78.1, C80.1, C82.1, C83.1, C84.1, C85.1, C86.1, C87.1, C88.1, C92.1, C93.1, C94.1, C96.1, C98.1, C99.1, C101.1, C103.1, C105.1, C108.1, C124.1, FB2.2, J2.3, J2.4, J3.1, J4.1, PB1.1, R6.1, R7.1, R13.1, R14.1, R15.1, R19.1, R21.1, R22.1, R24.1, R25.1, R26.1, R27.1, R28.1, R29.1, R31.2, R32.2, R36.1, R37.1, R39.1, R41.1, R42.1, R45.1, R46.1, R47.1, R48.1, R53.1, R67.1, R68.1, U1.C4, U1.E7, U1.E13, U1.F4, U1.F13, U1.H13, U1.J13, U1.L13, U1.M13, U1.N13, U5.3, U5.5, U5.9, U6.F2, U6.F3, U6.F4, U6.F5, U6.F6, U6.F7, U6.F8, U6.F9, U6.H3, U6.H8, U6.L2, U6.L4, U6.L7, U6.L9, U6.P3, U6.P8, U9.13, U9.36, U9.48, U11.1, U11.12, U11.27, U12.5, U13.6, U13.7
P3V3_PERM: C18.1, C54.1, C104.1, R12.1, U1.P12, U3.3, U3.4, U10.5, U14.5
P5V0: C1.1, C90.1, C91.1, C97.1, R30.1, U1.T12, U1.U12, U4.6, U4.7, U8.5, U14.1, U14.3
