jonasblixt/bebop/sw/board/pb/bebop/board.c

/**
 * Punch BOOT
 *
 * Copyright (C) 2018 Jonas Persson <jonpe960@gmail.com>
 *
 * SPDX-License-Identifier: BSD-3-Clause
 *
 */

#include <stdio.h>
#include <board.h>
#include <plat.h>
#include <io.h>
#include <gpt.h>
#include <image.h>
#include <boot.h>
#include <fuse.h>
#include <params.h>

#include <plat/imx6ul/plat.h>
#include <plat/regs.h>
#include <plat/imx/imx_uart.h>
#include <plat/imx/ehci.h>

#include <board/config.h>

const struct fuse fuses[] =
{
    IMX6UL_FUSE_BANK_WORD_VAL(3, 0, "SRK0",0x5020C7D7),
    IMX6UL_FUSE_BANK_WORD_VAL(3, 1, "SRK1",0xBB62B945),
    IMX6UL_FUSE_BANK_WORD_VAL(3, 2, "SRK2",0xDD97C8BE),
    IMX6UL_FUSE_BANK_WORD_VAL(3, 3, "SRK3",0xDC6710DD),
    IMX6UL_FUSE_BANK_WORD_VAL(3, 4, "SRK4",0x2756B777),
    IMX6UL_FUSE_BANK_WORD_VAL(3, 5, "SRK5",0xEF43BC0A),
    IMX6UL_FUSE_BANK_WORD_VAL(3, 6, "SRK6",0x7185604B),
    IMX6UL_FUSE_BANK_WORD_VAL(3, 7, "SRK7",0x3F335991),
    IMX6UL_FUSE_BANK_WORD_VAL(0, 5, "BOOT Config",        0x0000c060),
    IMX6UL_FUSE_BANK_WORD_VAL(0, 6, "BOOT from fuse bit", 0x00000010),
    IMX6UL_FUSE_END,
};


const struct partition_table pb_partition_table[] =
{
    PB_GPT_ENTRY(62768, PB_PARTUUID_SYSTEM_A, "System A"),
    PB_GPT_ENTRY(62768, PB_PARTUUID_SYSTEM_B, "System B"),
    PB_GPT_ENTRY(0x40000, PB_PARTUUID_ROOT_A, "Root A"),
    PB_GPT_ENTRY(0x40000, PB_PARTUUID_ROOT_B, "Root B"),
    PB_GPT_ENTRY(1, PB_PARTUUID_CONFIG_PRIMARY, "Config Primary"),
    PB_GPT_ENTRY(1, PB_PARTUUID_CONFIG_BACKUP, "Config Backup"),
    PB_GPT_END,
};

uint32_t board_early_init(struct pb_platform_setup *plat)
{

    plat->wdog.base = 0x020BC000;
    plat->usb0.base = EHCI_PHY_BASE,
    plat->tmr0.base = 0x02098000;
    plat->tmr0.pr = 24;

    plat->uart0.base = UART2_BASE;
    plat->uart0.baudrate = 80000000L / (2 * 115200);

    plat->usdhc0.base = 0x02190000;
    plat->usdhc0.clk_ident = 0x10E1;
    plat->usdhc0.clk = 0x0101;
    plat->usdhc0.bus_mode = USDHC_BUS_DDR52;
    plat->usdhc0.bus_width = USDHC_BUS_8BIT;
    plat->usdhc0.boot_bus_cond = 0;


    /* Configure UART */
    pb_write32(0, 0x020E0094);
    pb_write32(0, 0x020E0098);
    pb_write32(UART_PAD_CTRL, 0x020E0320);
    pb_write32(UART_PAD_CTRL, 0x020E0324);




    /* Configure pinmux for usdhc1 */
    pb_write32(0, 0x020E0000+0x1C0); /* CLK MUX */
    pb_write32(0, 0x020E0000+0x1BC); /* CMD MUX */
    pb_write32(0, 0x020E0000+0x1C4); /* DATA0 MUX */
    pb_write32(0, 0x020E0000+0x1C8); /* DATA1 MUX */
    pb_write32(0, 0x020E0000+0x1CC); /* DATA2 MUX */
    pb_write32(0, 0x020E0000+0x1D0); /* DATA3 MUX */
    pb_write32(1, 0x020E0000+0x1A8); /* DATA4 MUX */
    pb_write32(1, 0x020E0000+0x1AC); /* DATA5 MUX */
    pb_write32(1, 0x020E0000+0x1B0); /* DATA6 MUX */
    pb_write32(1, 0x020E0000+0x1B4); /* DATA7 MUX */
    pb_write32(1, 0x020E0000+0x1A4); /* RESET MUX */

    /* Enable USB PLL */
    pb_setbit32(1<<6, 0x020c8010);

    /* Power up USB */
    pb_setbit32( (1 << 31) | (1 << 30), 0x020c9038);
    pb_write32(0xFFFFFFFF, 0x020C9008);

    return PB_OK;
}

bool board_force_recovery(struct pb_platform_setup *plat)
{
    uint8_t force_recovery = false;
    UNUSED(plat);

    /* Check force recovery input switch */
   /* pb_write32(5, 0x020E0098);
    pb_write32(0x2000 | (2 << 14) | (1 << 12), 0x020E0324);

    if ( (pb_read32(0x0209C008) & (1 << 21)) == 0)
        force_recovery = true;

    pb_write32(0, 0x020E0098);
*/
    /* Connected to a charging port? enter recovery */
    if ((pb_read32(0x020c8000 + 0x1d0) & 0x02) == 0x02)
        force_recovery = true;

    return force_recovery;
}

uint32_t board_late_init(struct pb_platform_setup *plat)
{
    UNUSED(plat);
    return PB_OK;
}

uint32_t board_prepare_recovery(struct pb_platform_setup *plat)
{
    UNUSED(plat);
    return PB_OK;
}

uint32_t board_get_params(struct param **pp)
{
    param_add_str((*pp)++, "Board", "Bebop");
    return PB_OK;
}

uint32_t board_setup_device(struct param *params)
{
    UNUSED(params);
    return PB_OK;
}

uint32_t board_linux_patch_dt (void *fdt, int offset)
{
    UNUSED(fdt);
    UNUSED(offset);

    return PB_OK;
}

uint32_t board_recovery_command(uint32_t arg0, uint32_t arg1, uint32_t arg2,
                                uint32_t arg3)
{
    
    LOG_DBG("Board recovery command: %x, %x, %x, %x", arg0, arg1, arg2, arg3);

    if (arg0 == 0)
        return PB_OK;
    if (arg0 == 1)
        return PB_ERR;
}
